gmhull/Arduino-Flight-Controller/Imgs/Arms Closed - No Cover.jpg

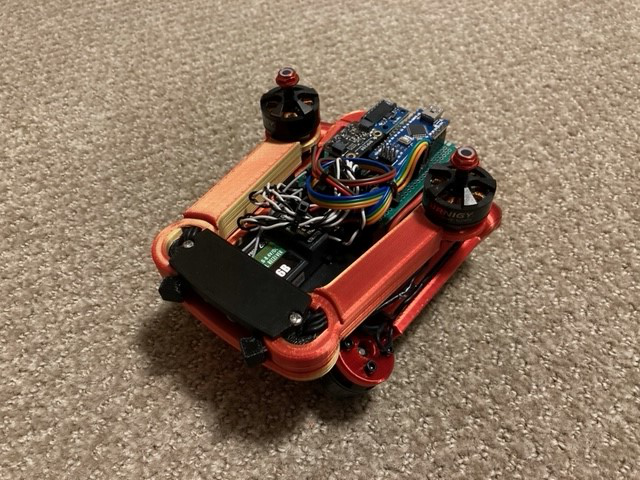
Imgs/Arms Closed - No Cover.jpg
