gmhull/Arduino-Flight-Controller/Imgs/Electronics Exposed.jpg

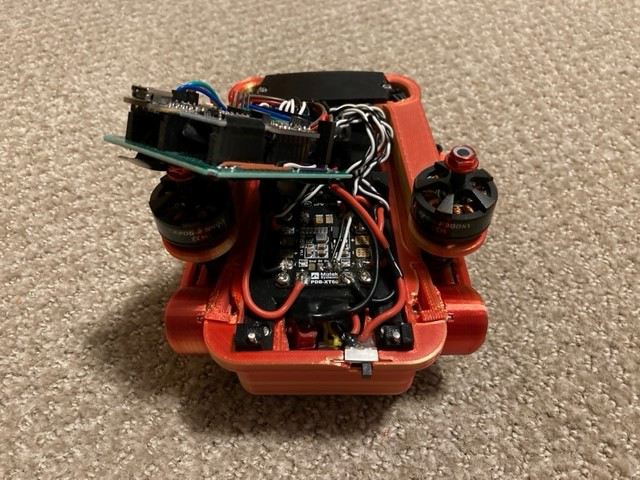
Imgs/Electronics Exposed.jpg
