gmhull/Arduino-Flight-Controller/Imgs/Wiring Schematic.png

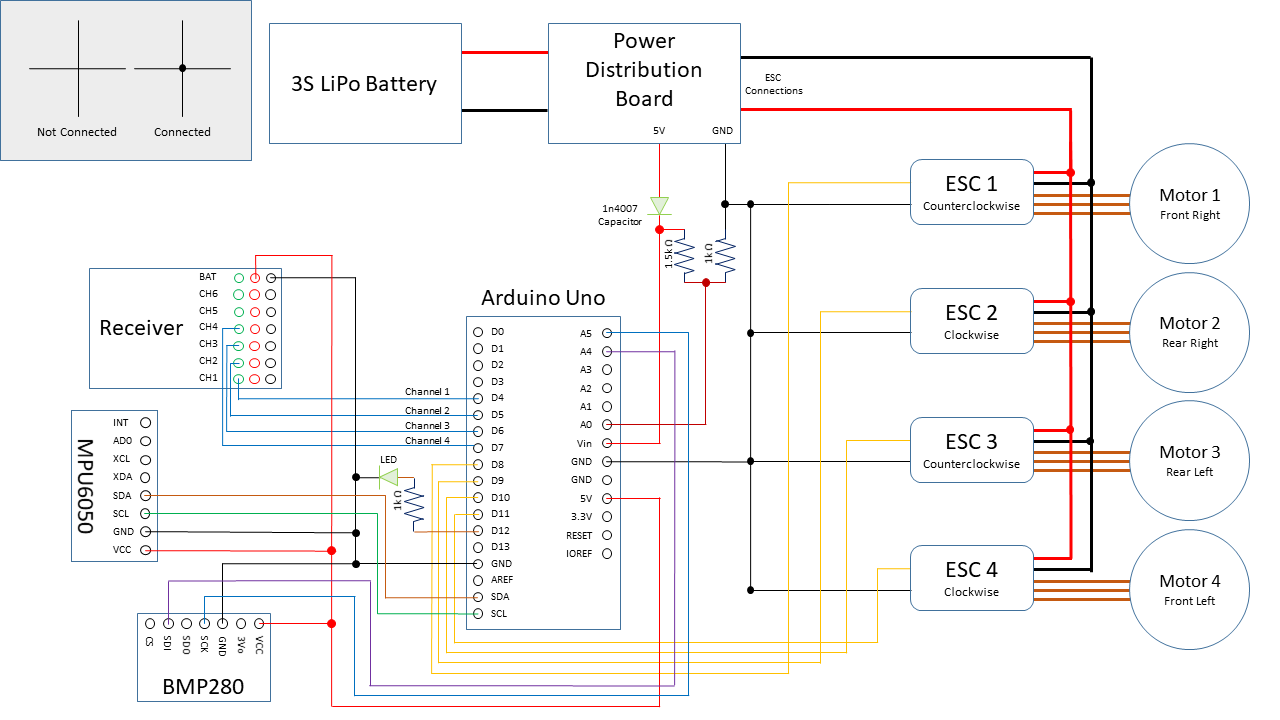
Imgs/Wiring Schematic.png
