gmhull/Arduino-Flight-Controller/Drone_Flight_Controller/calculate_pid.ino

///////////////////////////////////////////////////////////////////////////////////////////////////////////////////////////////////////
//Subroutine for calculating pid outputs
///////////////////////////////////////////////////////////////////////////////////////////////////////////////////////////////////////
void calculate_pid(){
  //Roll calculations
  pid_error_temp = gyro_roll_input - pid_roll_setpoint;
  pid_i_mem_roll += pid_i_gain_roll * pid_error_temp;
  if(pid_i_mem_roll > pid_max_roll)pid_i_mem_roll = pid_max_roll;
  else if(pid_i_mem_roll < pid_max_roll * -1)pid_i_mem_roll = pid_max_roll * -1;

  pid_output_roll = pid_p_gain_roll * pid_error_temp + pid_i_mem_roll + pid_d_gain_roll * (pid_error_temp - pid_last_roll_d_error);
  if(pid_output_roll > pid_max_roll)pid_output_roll = pid_max_roll;
  else if(pid_output_roll < pid_max_roll * -1)pid_output_roll = pid_max_roll * -1;

  pid_last_roll_d_error = pid_error_temp;

  //Pitch calculations
  pid_error_temp = gyro_pitch_input - pid_pitch_setpoint;
  pid_i_mem_pitch += pid_i_gain_pitch * pid_error_temp;
  if(pid_i_mem_pitch > pid_max_pitch)pid_i_mem_pitch = pid_max_pitch;
  else if(pid_i_mem_pitch < pid_max_pitch * -1)pid_i_mem_pitch = pid_max_pitch * -1;

  pid_output_pitch = pid_p_gain_pitch * pid_error_temp + pid_i_mem_pitch + pid_d_gain_pitch * (pid_error_temp - pid_last_pitch_d_error);
  if(pid_output_pitch > pid_max_pitch)pid_output_pitch = pid_max_pitch;
  else if(pid_output_pitch < pid_max_pitch * -1)pid_output_pitch = pid_max_pitch * -1;

  pid_last_pitch_d_error = pid_error_temp;

  //Yaw calculations
  pid_error_temp = gyro_yaw_input - pid_yaw_setpoint;
  pid_i_mem_yaw += pid_i_gain_yaw * pid_error_temp;
  if(pid_i_mem_yaw > pid_max_yaw)pid_i_mem_yaw = pid_max_yaw;
  else if(pid_i_mem_yaw < pid_max_yaw * -1)pid_i_mem_yaw = pid_max_yaw * -1;

  pid_output_yaw = pid_p_gain_yaw * pid_error_temp + pid_i_mem_yaw + pid_d_gain_yaw * (pid_error_temp - pid_last_yaw_d_error);
  if(pid_output_yaw > pid_max_yaw)pid_output_yaw = pid_max_yaw;
  else if(pid_output_yaw < pid_max_yaw * -1)pid_output_yaw = pid_max_yaw * -1;

  pid_last_yaw_d_error = pid_error_temp;
}
