gmhull/Arduino-Flight-Controller/Drone_Flight_Controller/convert_reciever_channel.ino

///////////////////////////////////////////////////////////////////////////////////////////////////////////////////////////////////////
//Subroutine for converting receiver signals into standardized 1000 – 1500 – 2000 microsecond values
///////////////////////////////////////////////////////////////////////////////////////////////////////////////////////////////////////
int convert_receiver_channel(byte function){
  byte channel, reverse;                                                       //First we declare some local variables
  int low, center, high, actual;
  int difference;

  channel = eeprom_data[function + 23] & 0b00000111;                           //What channel corresponds with the specific function
  if(eeprom_data[function + 23] & 0b10000000)reverse = 1;                      //Reverse channel when most significant bit is set
  else reverse = 0;                                                            //If the most significant is not set there is no reverse

  actual = receiver_input[channel];                                            //Read the actual receiver value for the corresponding function
  low = (eeprom_data[channel * 2 + 15] << 8) | eeprom_data[channel * 2 + 14];  //Store the low value for the specific receiver input channel
  center = (eeprom_data[channel * 2 - 1] << 8) | eeprom_data[channel * 2 - 2]; //Store the center value for the specific receiver input channel
  high = (eeprom_data[channel * 2 + 7] << 8) | eeprom_data[channel * 2 + 6];   //Store the high value for the specific receiver input channel

  if(actual < center){                                                         //The actual receiver value is lower than the center value
    if(actual < low)actual = low;                                              //Limit the lowest value to the value that was detected during setup
    difference = ((long)(center - actual) * signal_center) / (center - low);   //Calculate and scale the actual value to a 1000 - 2000us value
    if(reverse == 1)return 1000 + signal_center + difference;                  //If the channel is reversed
    else return 1000 + signal_center - difference;                             //If the channel is not reversed
  }
  else if(actual > center){                                                    //The actual receiver value is higher than the center value
    if(actual > high)actual = high;                                            //Limit the lowest value to the value that was detected during setup
    difference = ((long)(actual - center) * signal_center) / (high - center);  //Calculate and scale the actual value to a 1000 - 2000us value
    if(reverse == 1)return 1000 + signal_center - difference;                  //If the channel is reversed
    else return 1000 + signal_center + difference;                             //If the channel is not reversed
  }
  else return 1000 + signal_center;
}

int convert_throttle_receiver_channel(byte function){
  byte channel, reverse;                                                       //First we declare some local variables
  int low, center, high, actual;
  int difference;

  channel = eeprom_data[function + 23] & 0b00000111;                           //What channel corresponds with the specific function
  if(eeprom_data[function + 23] & 0b10000000)reverse = 1;                      //Reverse channel when most significant bit is set
  else reverse = 0;                                                            //If the most significant is not set there is no reverse

  actual = receiver_input[channel];                                            //Read the actual receiver value for the corresponding function
  low = (eeprom_data[channel * 2 + 15] << 8) | eeprom_data[channel * 2 + 14];  //Store the low value for the specific receiver input channel
  center = (eeprom_data[channel * 2 - 1] << 8) | eeprom_data[channel * 2 - 2]; //Store the center value for the specific receiver input channel
  high = (eeprom_data[channel * 2 + 7] << 8) | eeprom_data[channel * 2 + 6];   //Store the high value for the specific receiver input channel

  if (actual == 0){
    return 0;                                                                  //Return 0 if the receiver is not reading a signal
  }
  else if(actual < center){                                                    //The actual receiver value is lower than the center value
    if(actual < low)actual = low;                                              //Limit the lowest value to the value that was detected during setup
    difference = ((long)(center - actual) * throttle_signal_center) / (center - low);       //Calculate and scale the actual value to a 1000 - 2000us value
    if(reverse == 1)return 1000 + throttle_signal_center + difference;         //If the channel is reversed
    else return 1000 + throttle_signal_center - difference;                    //If the channel is not reversed
  }
  else if(actual > center){                                                    //The actual receiver value is higher than the center value
    if(actual > high)actual = high;                                            //Limit the lowest value to the value that was detected during setup
    difference = ((long)(actual - center) * throttle_signal_center) / (high - center);      //Calculate and scale the actual value to a 1000 - 2000us value
    if(reverse == 1)return 1000 + throttle_signal_center - difference;         //If the channel is reversed
    else return 1000 + throttle_signal_center + difference;                    //If the channel is not reversed
  }
  else return 1000 + throttle_signal_center;
}
