gmhull/Arduino-Flight-Controller/(commit log)

2022-08-17 Added wiring diagram
2022-09-05 Reduced throttle input range to reduce sensitivity
2022-09-20 Adjusted throttle range
2022-10-16 Update roll/pitch PID settings
2023-06-27 fix auto height mode
    [Drone_ESC_Calibrate.ino, Drone_Flight_Controller.ino, calculate_altitude.ino, get_barometer_data.ino, read_gyro.ino]
2023-07-10 Update PID vals
2024-03-21 update calibration
2024-04-30 Use LED_BUILTIN var
